ElektroBene/ekg/schematics/ekg_instr_opv.JPG

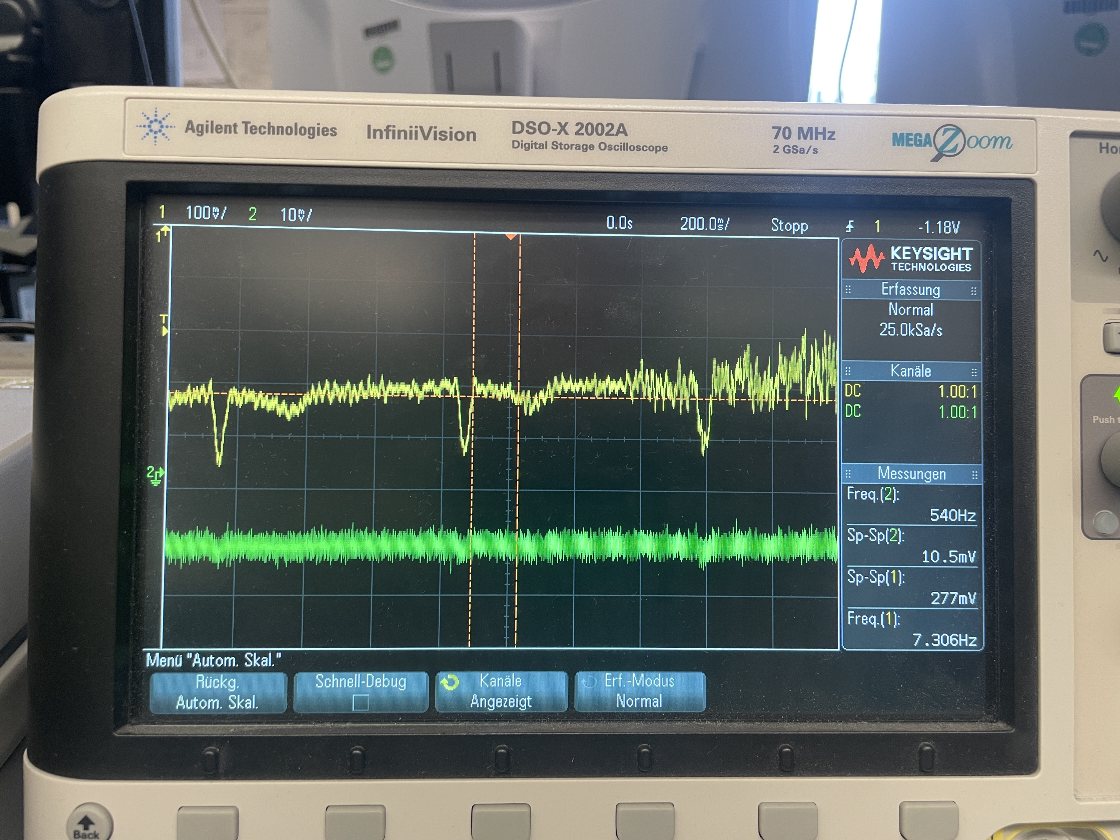
schematics/ekg_instr_opv.JPG
