ElektroBene/ekg/schematics/ekg_instr_opv_filter.JPG

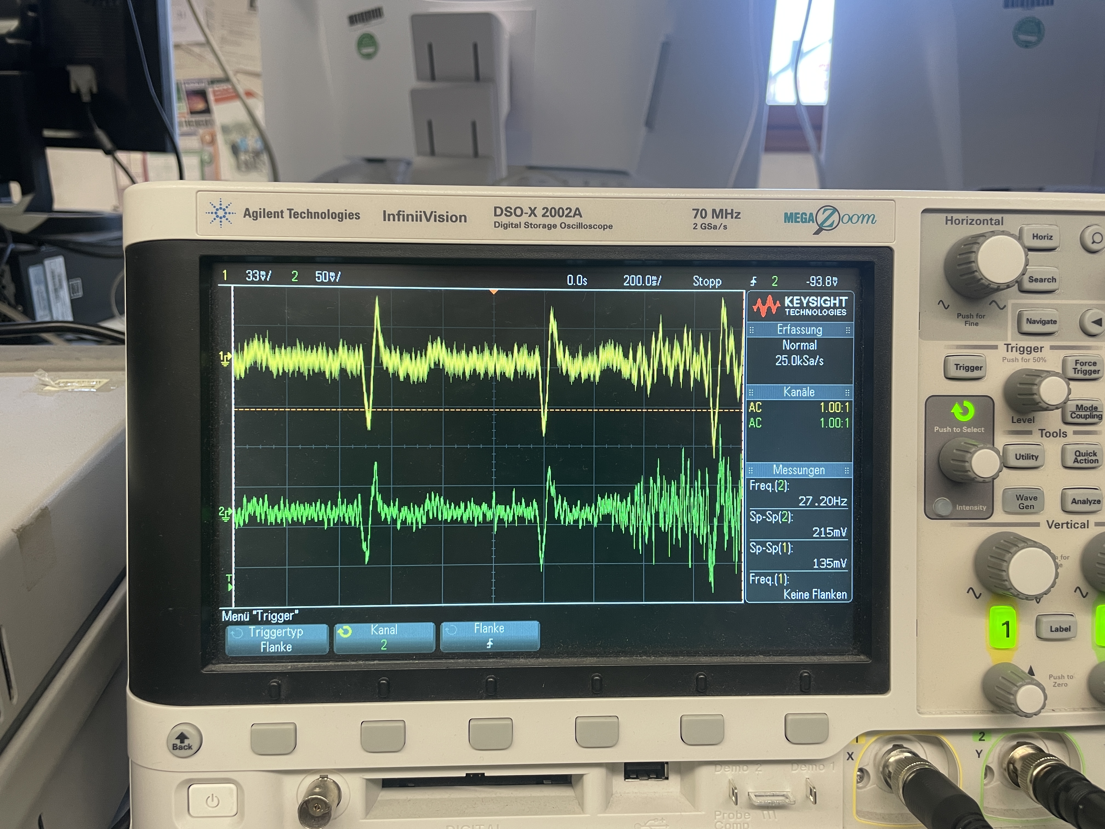
schematics/ekg_instr_opv_filter.JPG
