ElektroBene/ekg/README.md

# ekg
ecg/ekg interface between electrodes and oscilloscope
