ElektroBene/ekg/doc/EKG Abschlusspräsentation.pptx

## EKG-Schreiber

MSE – Teil Schaltungstechnik II

## Inhalt

  - Ziele
  - Theoretische Grundlagen
  - Schaltungskonzepte
  - Ergebnisse

## Ziele

  - analoge EKG-Schaltung
  - medizinisch verwertbar
  - Eingang: Elektroden
  - Ausgang: Spannungskurve am Oszilloskop

## Theorie

## Herzschlag

  - Aktionspotenziale im Sinusknoten
  - Verbreitung über Reizleitungssystem
  - Messung an der Haut

## Arten des EKGs

  - Brustwand-Ableitungen
  - Extremitäten-Ableitungen
  - Einthoven-Ableitungen: Potenzialdifferenzen

## Schaltungsumsetzung

## Überblick

  - Potenzialdifferenz
  - kleine Amplitude, Rauschen
  - Verstärker, Filter

## Instrumentationsverstärker

  - symmetrische Verstärker
  - Differenzverstärker
  - Potenzialtrennung
  - Ausgangsspannung:
U_a =(1+(R_1 +R_2)/(R_3))⋅(R_6)/(R_4)⋅(U_(e1) −U_(e2) )=2⋅(U_(e1) −U_(e2) )

## Vorverstärker

  - nicht invertierend
  - Verstärkung: v=1+(R_10)/(R_12)=101


## Tiefpass-Filter

  - Butterworth-Filter 3. Ordnung
  - hochfrequentes Rauschen + 50 Hz
  - -40 dB/Dekade
  - 3 dB-Grenzfrequenz bei 9 Hz


## Nachverstärker

  - nicht invertierend
  - Verstärkung: v=1+(R_8)/(R_9)=101
  - R11 für Eingangsruhestrom


## Switch

  - Umschaltung zwischen Einthoven-Ableitungen
  - 3 Eingänge → 2 Ausgänge

Schalterstellung (Seitenansicht) | Einthoven-Ableitung | Elektrodenkonfiguration
Links | Abl. II | RA → LF
Mitte | Abl. I | RA → LA
Rechts | Abl. III | LA → LF

## Layout

  - Entwicklung mit Eagle
  - Minimierung von Störungen


## Ergebnisse

## Analyse

  - gut erkennbar
  - leichte 50 Hz-Störungen
  - P-Welle: Vorhöfe
  - QRS-Komplex: Herzkammern
  - RR-Intervall: Herzfrequenz


## Optimierungen

  - steileres Filter bzw. Bandsperre
  - digitale Signalverarbeitung
  - Abschirmung
  - Goldberger-Ableitungen durch Addierer

## Erkenntnisse

  - medizinisch verwertbar mit einfachen Schaltungen
  - Strom im menschlichen Körper

## Dange Leude!
