ElektroBene/ekg/doc/EKG Präsentation Konzept.pptx

## EKG

ST II – Benedikt Schnörr

## Gliederung

- Aufgabe & Arten von EKGs
- Extremitäten-EKG
- Konzept

ST II - Benedikt Schnörr

## Aufgabe eines EKG

  - elektrische Aktivität des Herzens
  - Elektroden messen Potenzialdifferenzen
  - EKG-Zeitintervalle, Herzinfarkte, vektorielle Deutung
  - Extremitäten vs. Brustwand

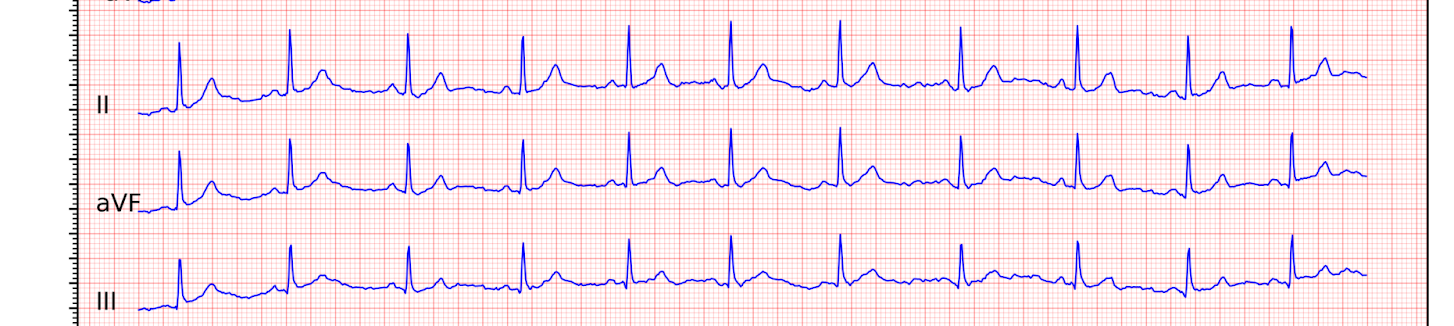
[picture p18: figure]
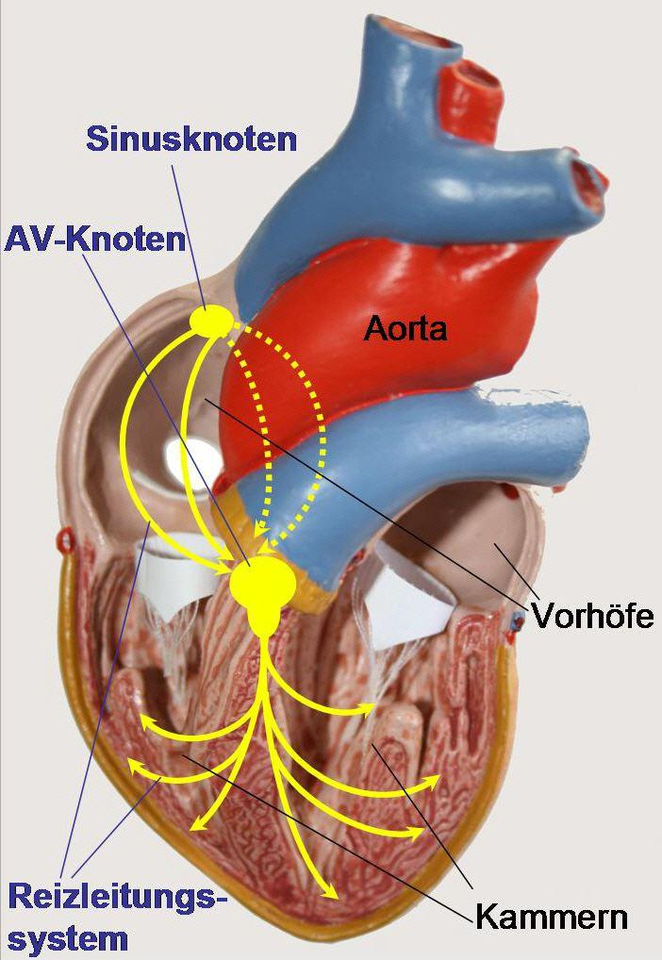
[picture p19: figure]
Darstellung des Herzzyklus simultan zum EKG hier.

## Extremitäten-EKG: Ableitungen

Einthoven-Ableitungen
  - Differenz zwischen 2 Elektroden
  - Einthoven-Dreieck

Goldberger-Ableitungen
  - Differenz von einer Elektrode zu Summe der anderen Elektroden
  - Bessere vektorielle Deutung

EKG triaxiales hexaaxiales System Einthoven Dreieck
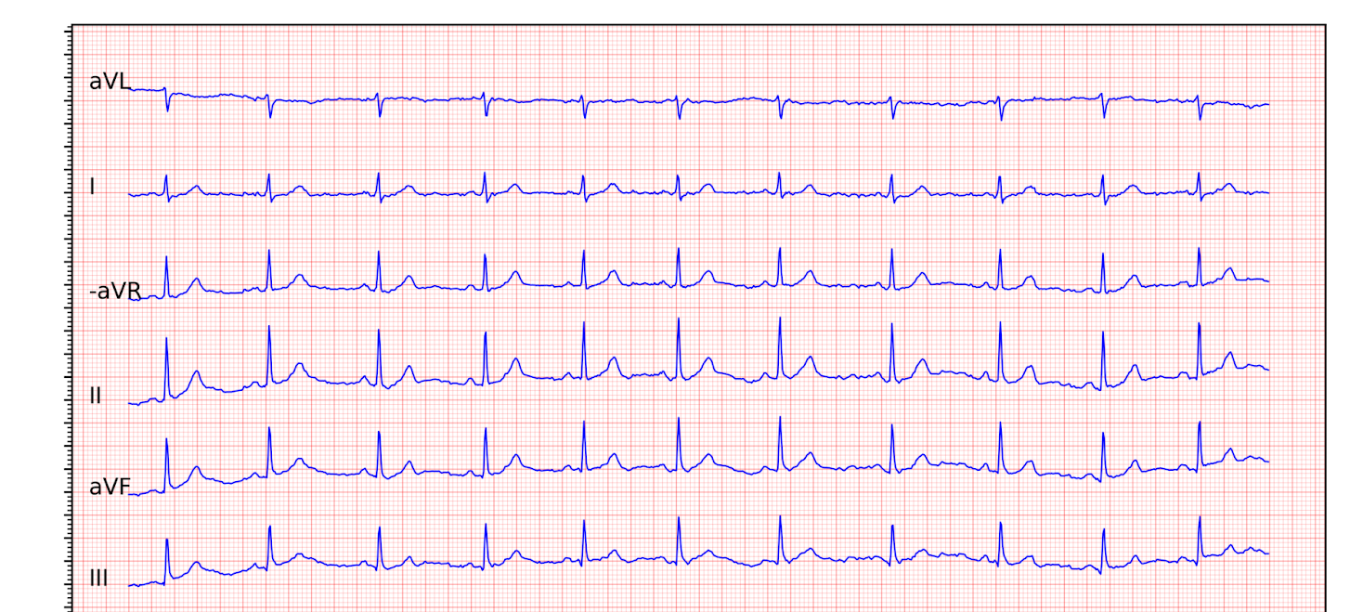
[picture p20: figure]
EXK Goldberger Ableitungen

## Konzept

  - Analoge Schaltung zwischen Elektroden und Oszi
  - Nur Einthoven-Ableitungen
  - Switch für Konfigurationen

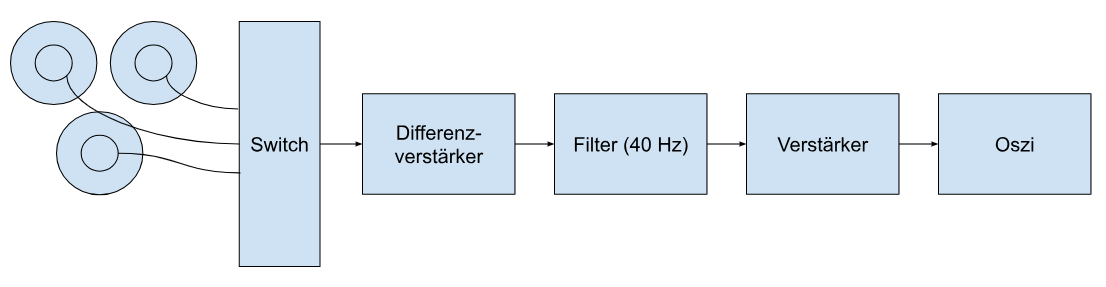
[picture p21: figure]

## Ausgang der Elektroden

  - 50 Hz Sinus → Störungen durch Netzspannung
  - Hochfrequentes Rauschen

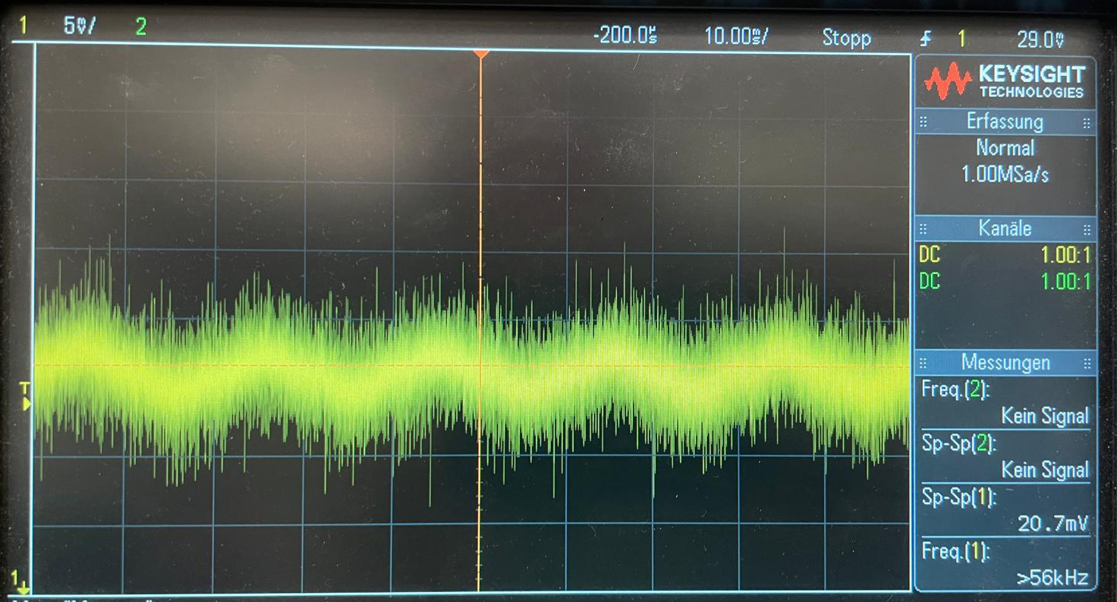
[picture p22: figure]

T=20ms

## Quellen

  - https://www.fokus-ekg.de/aktuelles/elektrophysikalische-und-physiologische-grundlagen/prinzip/
  - https://www.fokus-ekg.de/inhalt-von-a-z/ekg-ableitungen/einthoven-ableitungen/
  - Anatomie Herz: https://www.main-herz.de/images/pictures/612d12d2/612d12d3/612d12d4/website_reizleitungssystem.jpg

## Danke für Ihre Aufmerksamkeit!

Gibt‘s noch Fragen?
