ElektroBene/ekg/layout/st_ekg_v1/st_ekg_v1_layout.png

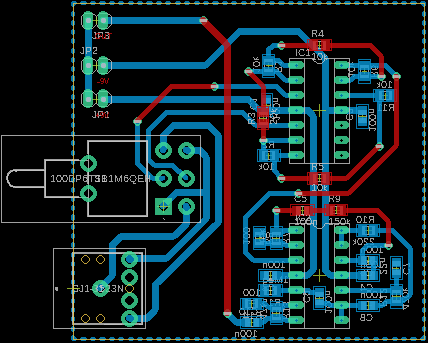
layout/st_ekg_v1/st_ekg_v1_layout.png
