ElektroBene/ekg/layout/st_ekg_v1/st_ekg_v1_layout_bright.png

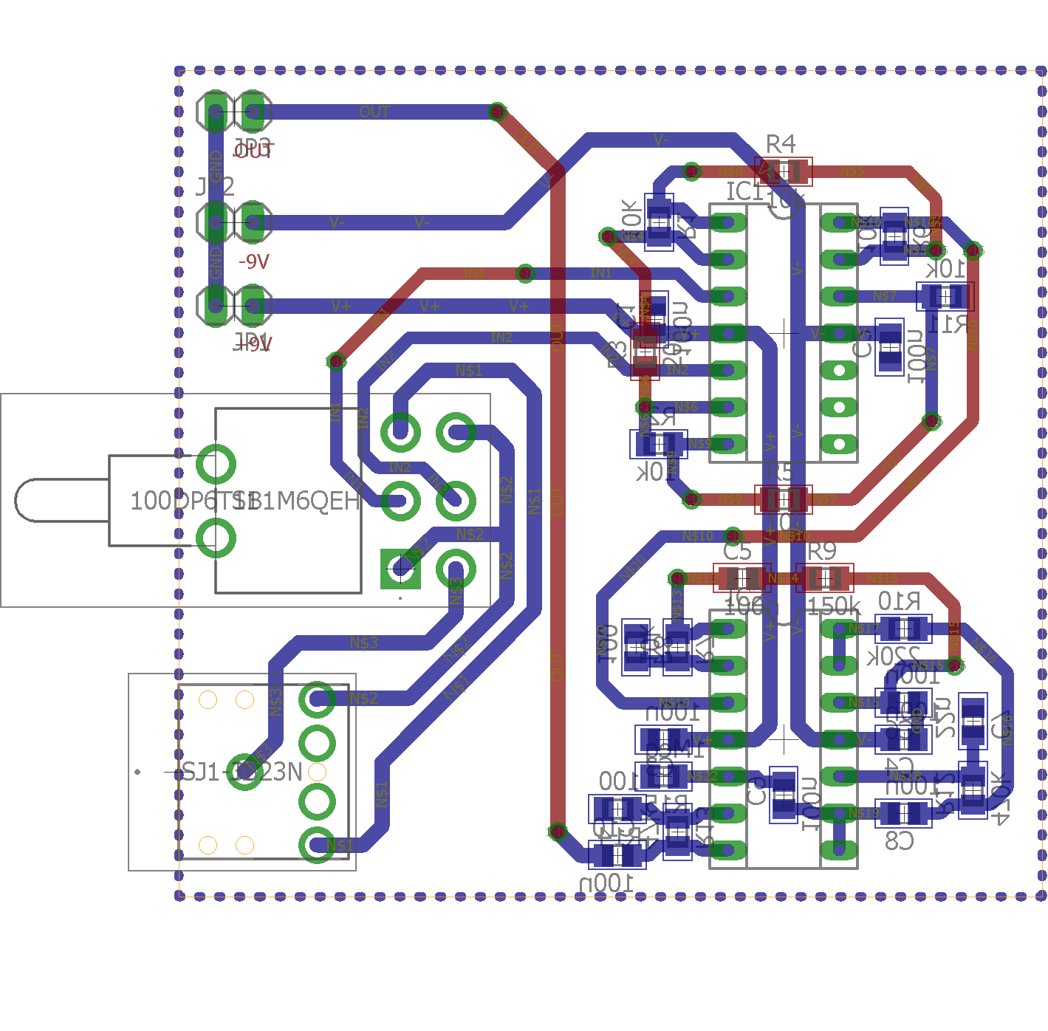
layout/st_ekg_v1/st_ekg_v1_layout_bright.png
