ElektroBene/ekg/schematics/st_ekg_instr_verst.PNG

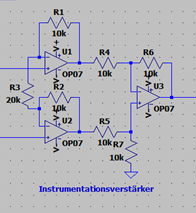
schematics/st_ekg_instr_verst.PNG
