ElektroBene/ekg/schematics/st_ekg_instr_verst_beschr.png

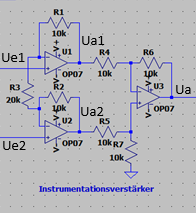
schematics/st_ekg_instr_verst_beschr.png
