ElektroBene/ekg/schematics/st_ekg_schematics.PNG

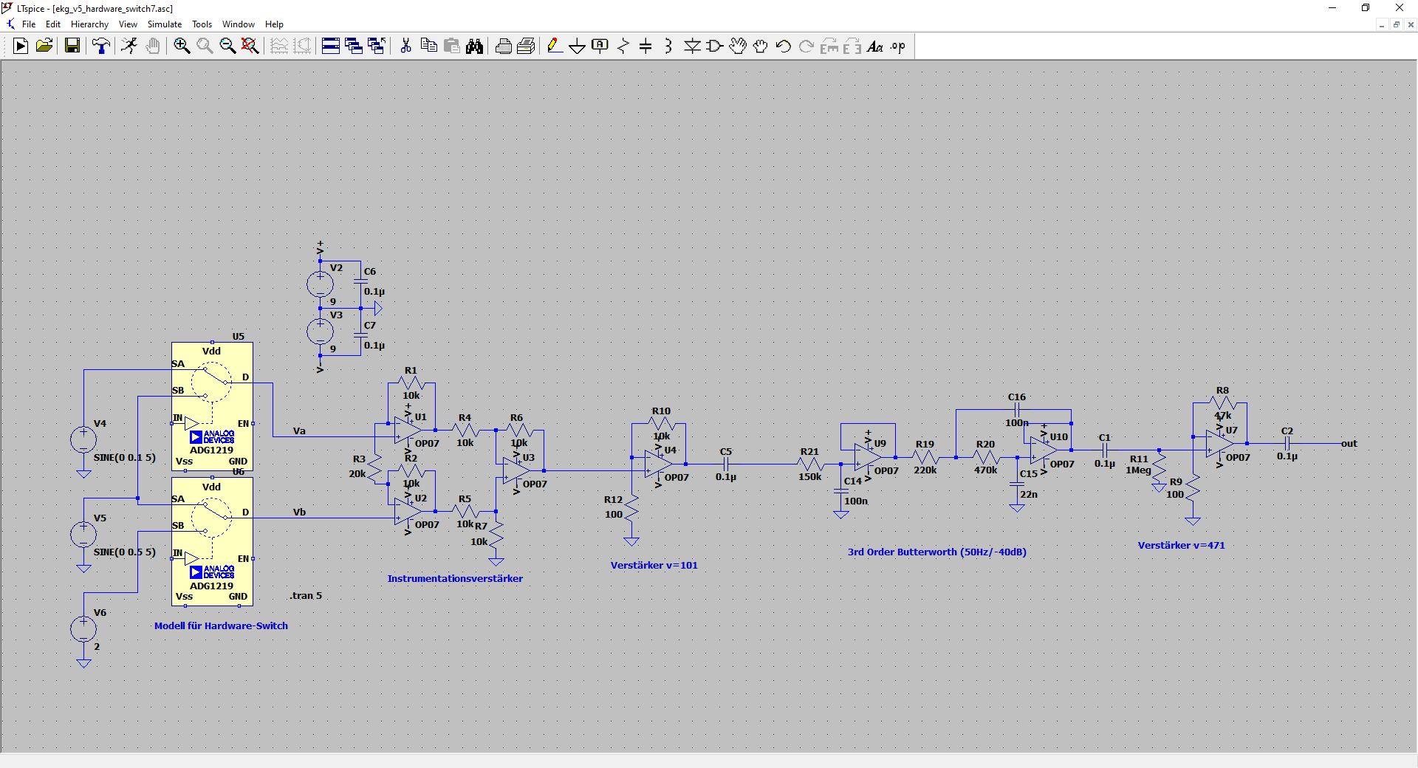
schematics/st_ekg_schematics.PNG
