ElektroBene/ekg/schematics/ekg_v5_hardware_switch7.asc

C1: cap; 0.1µ
C2: cap; 0.1µ
C5: cap; 0.1µ
C6: cap; 0.1µ
C7: cap; 0.1µ
C14: cap; 100n
C15: cap; 22n
C16: cap; 100n
R1: res; 10k
R2: res; 10k
R3: res; 20k
R4: res; 10k
R5: res; 10k
R6: res; 10k
R7: res; 10k
R8: res; 47k
R9: res; 1k
R10: res; 10k
R11: res; 1Meg
R12: res; 100
R19: res; 220k
R20: res; 470k
R21: res; 150k
U1: OP07
U2: OP07
U3: OP07
U4: OP07
U5: ADG1219
U6: ADG1219
U7: OP07
U9: OP07
U10: OP07
V2: voltage; 9
V3: voltage; 9
V4: voltage; SINE(0 0.1 5)
V5: voltage; SINE(0 0.5 5)
V6: voltage; 2
Named nets: 0, V+, V-, Va, Vb, out
Instrumentationsverstärker
.tran 5
Verstärker v=101
3rd Order Butterworth (50Hz/-40dB)
Modell für Hardware-Switch
Verstärker v=47
