ElektroBene/ekg/schematics/ekg_v2_butterworth.asc

C1: cap; 100n
C2: cap; 22n
C3: cap; 0.1µ
C4: cap; 100n
C5: cap; 0.1µ
C6: cap; 0.1µ
C7: cap; 0.1µ
C8: cap; 10µ
C9: cap; 1µ
C10: cap; 0.1µ
C11: cap; 100n
C12: cap; 22n
C13: cap; 100n
C14: cap; 100n
C15: cap; 22n
C16: cap; 100n
R1: res; 10k
R2: res; 10k
R3: res; 20k
R4: res; 10k
R5: res; 10k
R6: res; 10k
R7: res; 10k
R8: res; 159k
R9: res; 236k
R10: res; 10k
R11: res; 487k
R12: res; 100
R13: res; 220
R14: res; 2.2k
R15: res; 22k
R16: res; 220k
R17: res; 470k
R18: res; 150k
R19: res; 330k
R20: res; 500k
R21: res; 220k
U1: OP07
U2: OP07
U3: OP07
U4: OP07
U5: OP07
U6: OP07
U7: OP07
U8: OP07
U9: OP07
U10: OP07
V1: voltage; ""; AC 0.5
V2: voltage; 9
V3: voltage; 9
Named nets: 0, V+, V-, Va, Vb
Instrumentationsverstärker
.ac dec 10000 1 1000
Verstärker v=100
3rd Order Butterworth (50Hz/-40dB)
