ElektroBene/ekg/schematics/ekg_v1.asc

C1: cap; 10µ
C2: cap; 1µ
C3: cap; 0.1µ
C4: cap; .1µ
C5: cap; 0.1µ
C6: cap; 0.1µ
C7: cap; 0.1µ
R1: res; 10k
R2: res; 10k
R3: res; 20k
R4: res; 10k
R5: res; 10k
R6: res; 10k
R7: res; 10k
R8: res; 220
R9: res; 2.2k
R10: res; 10k
R11: res; 22k
R12: res; 100
U1: OP07
U2: OP07
U3: OP07
U4: OP07
V1: voltage; ""; AC 0.5
V2: voltage; 9
V3: voltage; 9
Named nets: 0, V+, V-, Va, Vb
Instrumentationsverstärker
.ac dec 10000 1 1000
Tiefpass 65 Hz
Verstärker v=100
