ElektroBene/ekg/layout/st_ekg_v1/st_ekg_v1.brd

## EAGLE design layout/st_ekg_v1/st_ekg_v1.brd (2025-01-12)

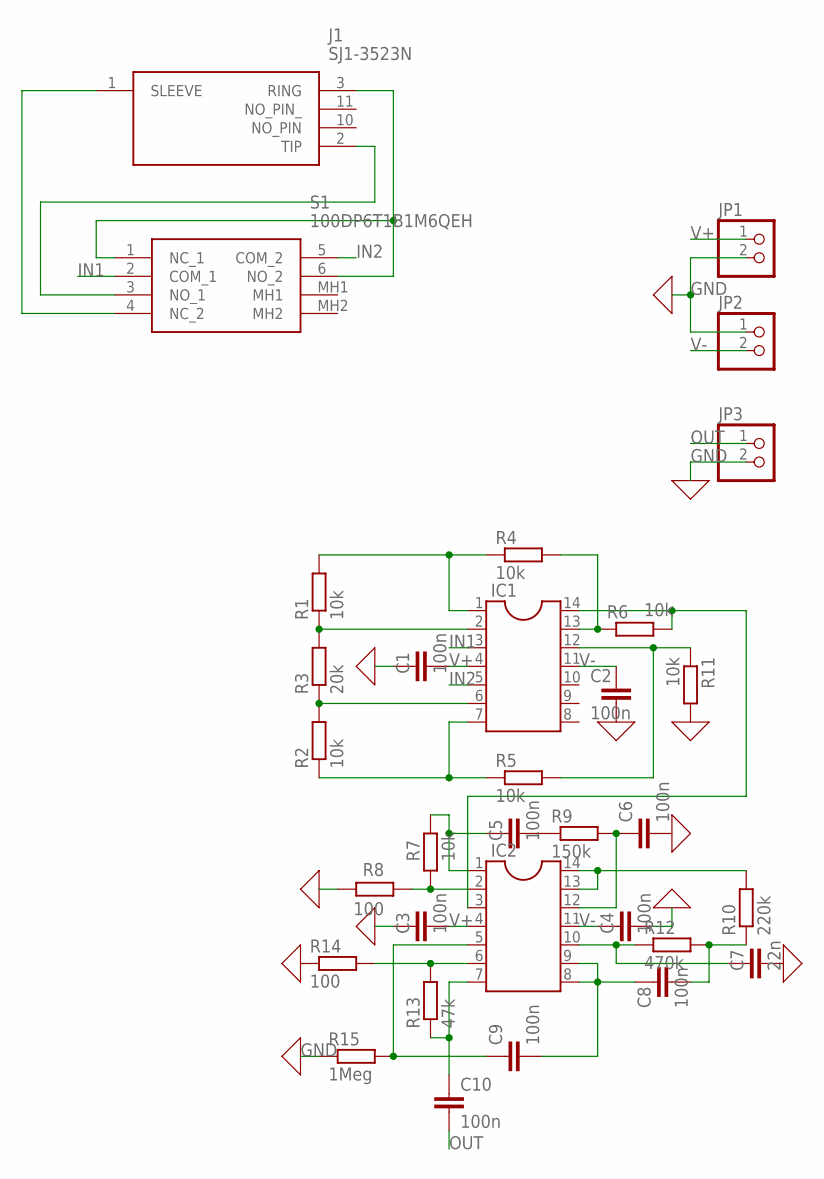
[picture p28: schematic st_ekg_v1.sch]

Parts:
C1, C2, C3, C4, C5, C6, C8, C9, C10: 100n; C0805
C7: 22n; C0805
IC1, IC2: DIL14S; SOCKET-14
J1: SJ1-3523N; SJ13523N
JP1, JP2, JP3: PINHD-1X2; 1X02
R1, R2, R4, R5, R6, R7, R11: 10k; M0805
R3: 20k; M0805
R8, R14: 100; M0805
R9: 150k; M0805
R10: 220k; M0805
R12: 470k; M0805
R13: 47k; M0805
R15: 1Meg; M0805
S1: 100DP6T1B1M6QEH

Connections:
GND: C1.1, C2.2, C3.1, C4.2, C6.2, C7.2, JP1.2, JP2.1, JP3.2, R8.2, R11.2, R14.1, R15.1
IN1: IC1.3, S1.2 (COM_1)
IN2: IC1.5, S1.5 (COM_2)
unnamed: J1.2 (TIP), S1.3 (NO_1)
unnamed: J1.3 (RING), S1.1 (NC_1), S1.6 (NO_2)
unnamed: J1.1 (SLEEVE), S1.4 (NC_2)
unnamed: IC1.2, R1.1, R3.2
unnamed: IC1.13, R4.2, R6.1
unnamed: IC1.6, R2.2, R3.1
unnamed: IC1.12, R5.2, R11.1
unnamed: IC1.1, R1.2, R4.1
unnamed: IC1.7, R2.1, R5.1
unnamed: IC1.14, IC2.3, R6.2
unnamed: IC2.2, R7.1, R8.1
unnamed: C5.1, IC2.1, R7.2
unnamed: C5.2, R9.1
unnamed: C6.1, IC2.12, R9.2
unnamed: C8.2, R10.1, R12.2
unnamed: IC2.13, IC2.14, R10.2
unnamed: C7.1, IC2.10, R12.1
unnamed: C8.1, C9.2, IC2.8, IC2.9
unnamed: C9.1, IC2.5, R15.2
unnamed: IC2.6, R13.2, R14.2
unnamed: C10.1, IC2.7, R13.1
OUT: C10.2, JP3.1
V+: C1.2, C3.2, IC1.4, IC2.4, JP1.1
V-: C2.1, C4.1, IC1.11, IC2.11, JP2.2

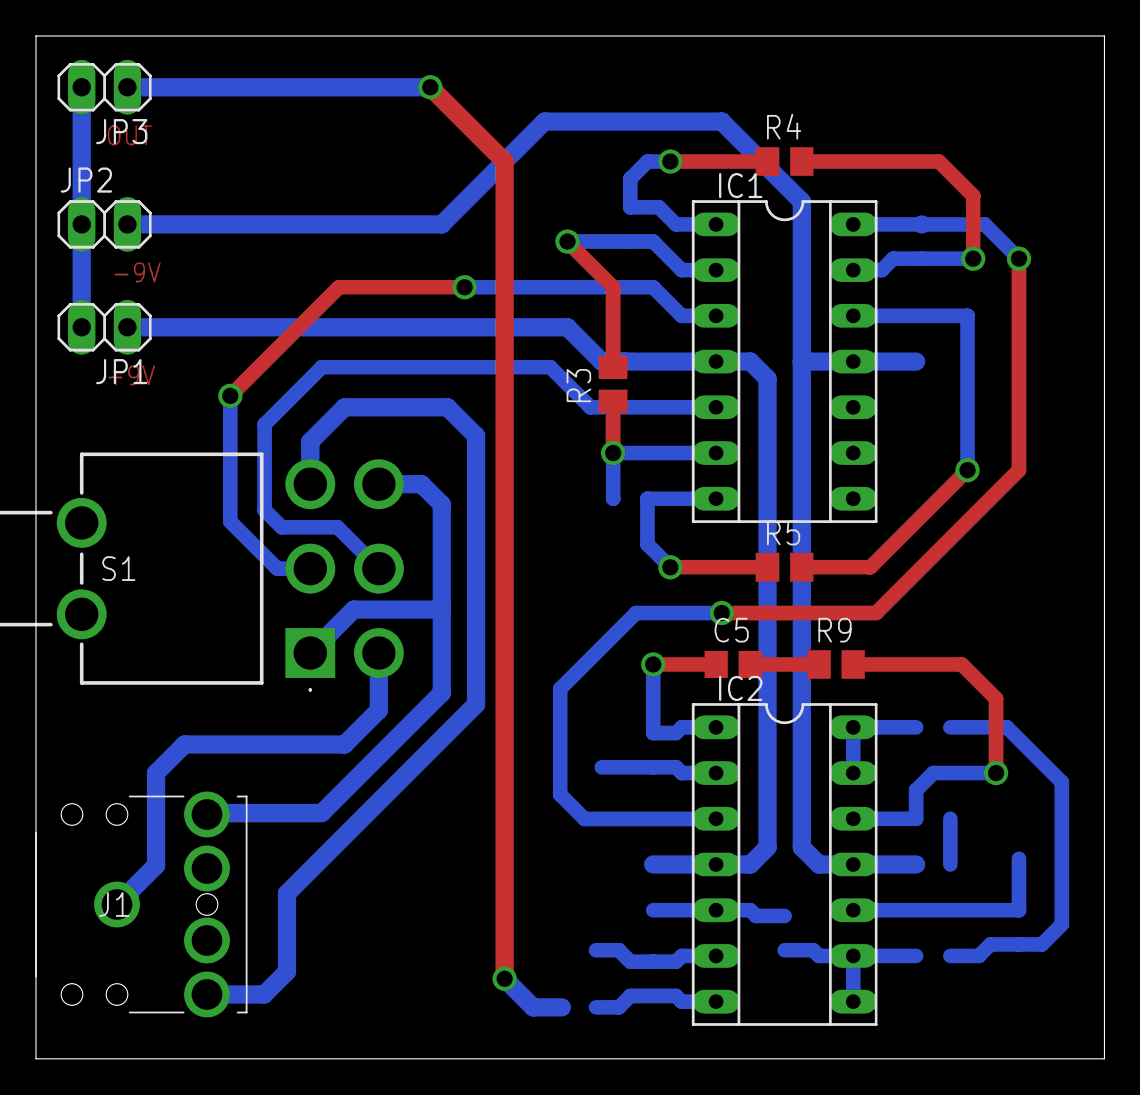
[picture p29: board st_ekg_v1.brd from above]

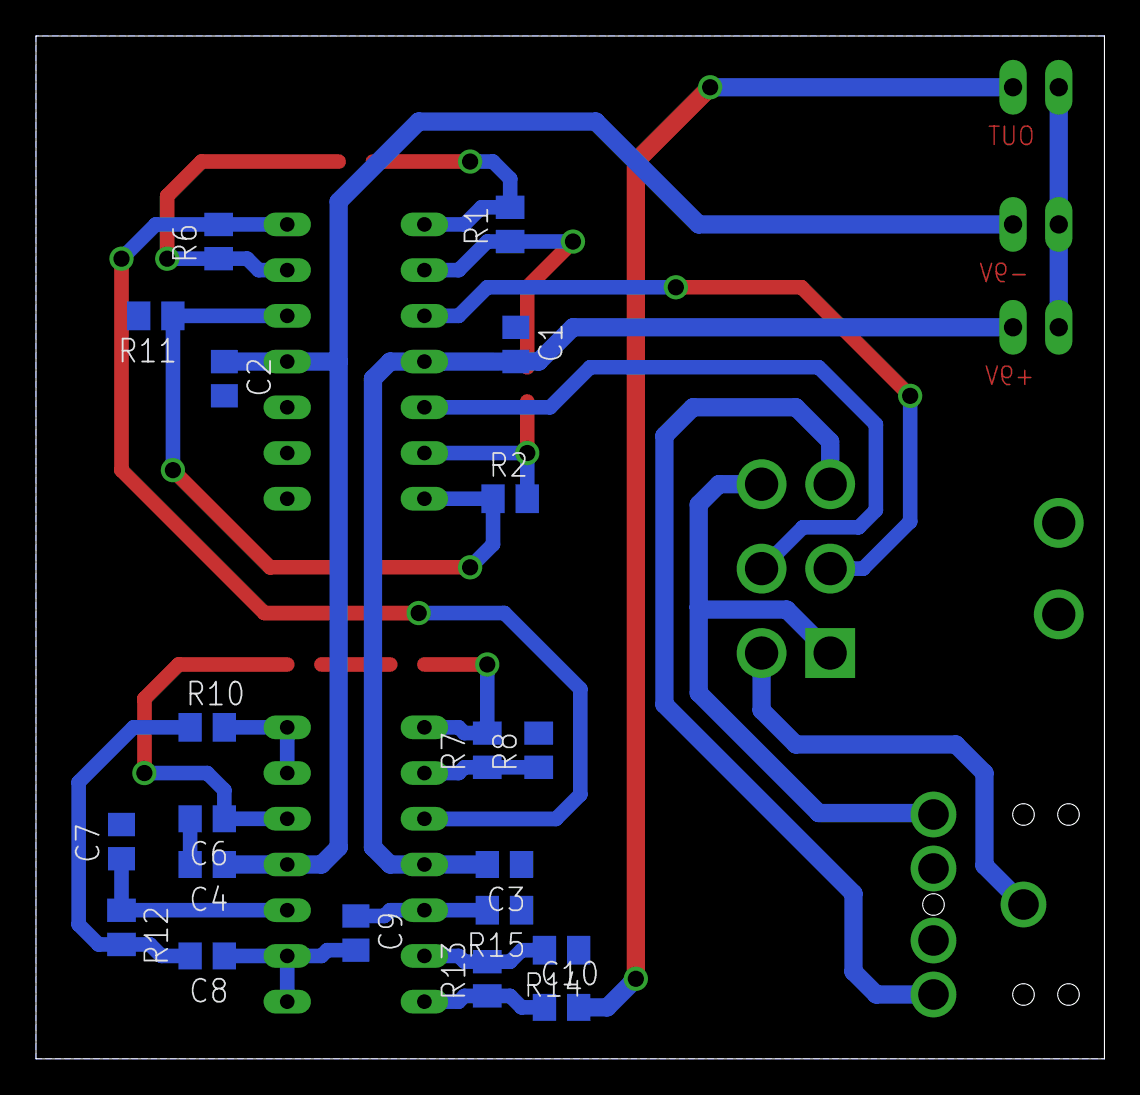
[picture p30: board st_ekg_v1.brd from below]

Board: 2 copper layers, 59.4 x 56.8 mm, 32 parts (20 on the bottom side), 27 nets.
