ElektroBene/ekg/(commit log)

2024-12-03 Initial commit including schematics for amplifiers and filters and basic concept
2024-12-15 Add first full version of layout
    [st_ekg_v1.brd, st_ekg_v1.sch]
2024-12-16 Modify layout to include only bottom paths on pin headers
    [st_ekg_v1.brd]
2024-12-17 Minor modifications
    [st_ekg_v1.brd]
2025-01-12 Add photos of layout and schematics
    [st_ekg_v1.brd, st_ekg_v1.sch]
2025-01-12 Add final version of documentation
    [st_ekg_v1.sch]
